willemmath/Bachelorproef-2022/Administratie/Interessante info.txt

Interessante links/info

Impulse response REW
https://www.roomeqwizard.com/help/help_en-GB/html/impulseresponse.html

Quasi-anechoic measurement
https://www.audiosciencereview.com/forum/index.php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

beamforming
https://www.hindawi.com/journals/jece/2013/718574/#EEq5

USB audio PIC
https://www.microchip.com/en-us/solutions/consumer/audio-and-speech/pic32-digital-audio/pic32-usb-audio#

USB noise
https://andybrown.me.uk/2015/07/24/usb-filtering/

USB margins clock
https://docs.opentitan.org/hw/ip/usbdev/doc/#:~:text=The%20USB%20Full%2DSpeed%20interface,accurate%2048%20MHz%20clock%20source.
