willemmath/Bachelorproef-2022/Administratie/Weekverslagen/weekv_6_Willem_Mathieu_EI.docx

# Tussentijds opvolgingsformulier Bachelorproef 2021-2022

__

Bachelorproef: MEMS microfoon in pro audio

Bedrijf: Thomas More

Student: Willem Mathieu

Promotor: Nick Steen

Bedrijfspromotor: Pedro Wyns

Opleiding: Elektronica-ICT Embedded Hardware

Stageweek: Week 6

Gerealiseerd vorige week:

PCB schematic gemaakt.

Begonnen aan de PCB layout.

Doelstellingen voor de volgende week:

PCB Layout afwerken.

PCB bestellen.

Opmerkingen bedrijfspromotor:

Opmerkingen hogeschoolpromotor:
