willemmath/Bachelorproef-2022/Administratie/Weekverslagen/weekv_7_Willem_Mathieu_EI.docx

# Tussentijds opvolgingsformulier Bachelorproef 2021-2022

__

Bachelorproef: MEMS microfoon in pro audio

Bedrijf: Thomas More

Student: Willem Mathieu

Promotor: Nick Steen

Bedrijfspromotor: Pedro Wyns

Opleiding: Elektronica-ICT Embedded Hardware

Stageweek: Week 7

Gerealiseerd vorige week:

PCB layout verder uitgewerkt.

Extra componenten besteld.

Doelstellingen voor de volgende week:

PCB Layout afwerken.

PCB bestellen.

Opmerkingen bedrijfspromotor:

Opmerkingen hogeschoolpromotor:
