willemmath/Bachelorproef-2022/Administratie/Weekverslagen/weekv_X_Willem_Mathieu_EI.docx

# Tussentijds opvolgingsformulier Bachelorproef 2021-2022

__

Bachelorproef: MEMS microfoon in pro audio

Bedrijf: Thomas More

Student: Willem Mathieu

Promotor: Nick Steen

Bedrijfspromotor: Pedro Wyns

Opleiding: Elektronica-ICT Embedded Hardware

Stageweek: Week x

Gerealiseerd vorige week:

Doelstellingen voor de volgende week:

Opmerkingen bedrijfspromotor:

Opmerkingen hogeschoolpromotor:
