willemmath/Bachelorproef-2022/Administratie/Weekverslagen/Week4_teamgantt.pdf

1114 | 21 | 28
7 | 14 | 21 | 28
4 | 11 | 18 | 25

2

9 | 16 | 23
2/22 | 3/22 | 4/22 | 5/22
MEMS Pro Audio | 0h | 42%
Administratie | 0h | 64%
Opstartverlsag afmaken
0 100%
Github opstellen
0 100%
Template weekverslag maken 0 100%
Week 1
0 100%
Week 2
0 100%
Week 3
0 100%
Week 4
0 | 0%
Week 5
0 | 0%
Week 6
0 | 0%
Week 7
0 | 0%
Week 8
0 | 0%
Week 9
0 | 0%
Week 10
0 | 0%
Week 11
0 | 0%
Week 12
0 | 0%
Les scriptie
0 100%
Les presentatie
0 | 100%
Marktonderzoek | 0h | 100%
Zoeken en bestellen
0 100%
Info verzamelen test-items
0 100%
Ontvangen van bestelling
0 100%
Solderen van connectoren
0 100%
testen van componenten
0 100%
Mock test-setup opstellen
0 100%
REW of alternatief opstellen 0 100%
Acoustische kamer opstellen 0 100%
Meting van componenten
0 100%
Analyse en selectie van MEMS 0 100%
Marktonderzoek gedaan
0 | 100%
Prototype ontwikkelen | 0h | 20%
Onderzoek USB audio class
0 | 80%
Onderzoek noise cancelling
0 100%
Concept uitwerken
0 | 90%
Componenten kiezen
0 | 30%
PCB ontwerpen
0 | 0%
PCB bestellen
0 | 0%
Componenten bestellen
0 | 0%
PCB ontvangen
0 | 0%
Componenten ontvangen
0 | 0%
PCB bestukken
0 | 0%
PCB software integreren
0 | 0%
Behuizing ontwerpen
0 | 0%
Behuizing maken
0 | 0%
Breadboard versie samenstellen
0 | 0%
Breadboard programmeren
0 | 0%
DSP verdiepend onderzoek
0 | 0%
DSP Programmeren
0 | 0%

Powered by TCPDF (www.tcpdf.org)
