willemmath/Bachelorproef-2022/Administratie/Weekverslagen/Week2_teamgantt.pdf

1114 | 21 | 28
7 | 14 | 21 | 28
4 | 11 | 18 | 25

2

9 | 16 | 23
2/22 | 3/22 | 4/22 | 5/22
MEMS Pro Audio | 23%
Administratie | 56%
Opstartverlsag afmaken | 100%
Github opstellen | 100%
Template weekverslag maken | 100%
Week 1 | 100%
Week 2 | 90%
Week 3 | 0%
Week 4 | 0%
Week 5 | 0%
Week 6 | 0%
Week 7 | 0%
Week 8 | 0%
Week 9 | 0%
Week 10 | 0%
Week 11 | 0%
Week 12 | 0%
Les scriptie | 100%
Les presentatie | 0%
Marktonderzoek | 76%
Zoeken en bestellen | 100%
Info verzamelen test-items | 100%
Ontvangen van bestelling | 100%
Solderen van connectoren | 100%
testen van componenten | 100%
Mock test-setup opstellen | 100%
REW of alternatief opstellen | 100%
Acoustische kamer opstellen | 100%
Meting van componenten | 30%
Analyse en selectie van MEMS | 0%
Marktonderzoek gedaan | 0%
Prototype ontwikkelen | 0%
Onderzoek USB audio class | 0%
Onderzoek noise cancelling | 0%
Concept uitwerken | 0%
Componenten kiezen | 0%
PCB ontwerpen | 0%
PCB bestellen | 0%
Componenten bestellen | 0%
PCB ontvangen | 0%
Componenten ontvangen | 0%
PCB bestukken | 0%
PCB software integreren | 0%
Behuizing ontwerpen | 0%
Behuizing maken | 0%
Breadboard versie samenstellen | 0%
Breadboard programmeren | 0%
DSP verdiepend onderzoek | 0%
DSP Programmeren | 0%

Powered by TCPDF (www.tcpdf.org)
