willemmath/Bachelorproef-2022/Administratie/Content/Presentatie/tussentijdse/tussentijdse presentatie.pptx

## Haalbaarheidsonderzoek betreffende het gebruik van de nieuwste generatie MEMS microfoons voor professionele audio

1/12

Willem Mathieu

## Waar?

- Thomas More
- Pedro Wyns

2/12

## Wat?

3/12

Haalbaarheidsonderzoek
MEMS technologie in pro audio
Product ontwikkelen
Berekeningen
Ontwerpen
Produceren
Metingen

## Haalbaarheidsonderzoek

- Wat is een MEMS?
  - Micro ElectroMechanical System
  - Mechanisch systeem op een IC
  - Veel terug te vinden op smart-devices

4/12

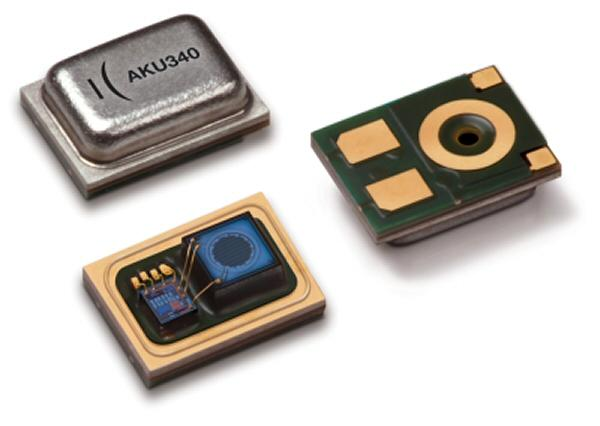
[picture p56: figure]
Innovations and Trends on the rising curve to prove favorable for growth of MEMS Microphone Market

## Haalbaarheidsonderzoek

- Testen van verschillende MEMS microfoons
- Vergelijken met andere microfoons
- Analyse en conclusies trekken

5/12

## Product ontwikkelen

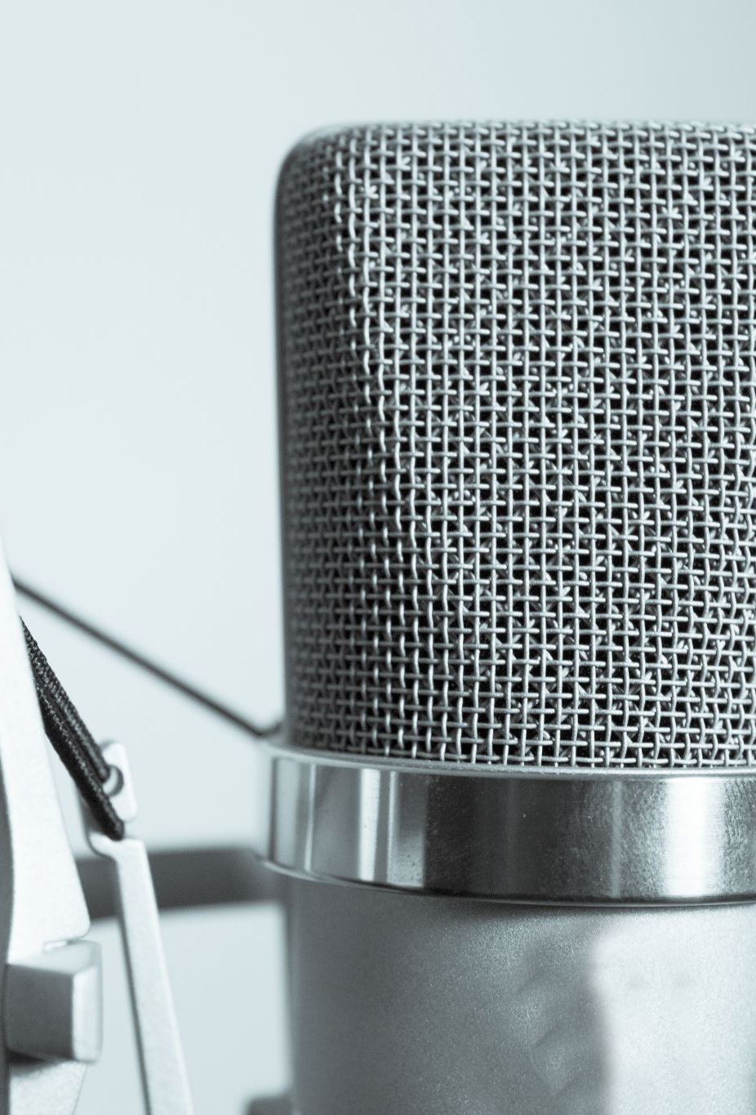
[picture p57: figure]
Microfoon tegen een witte achtergrond

6/12

- Zelf een microfoon ontwikkelen
  - Met MEMS
  - USB verbinding
  - Een vorm van noise cancelling
  - DSP technieken

## Wat heb ik al bereikt?

7/12

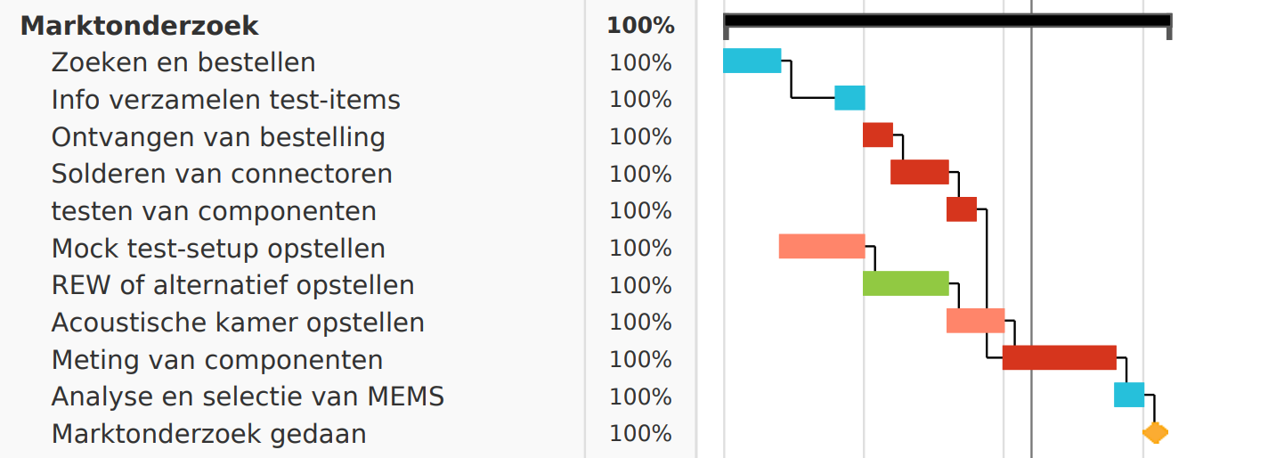
[picture p58: figure]

## Resultaten onderzoek

8/12

Naam | Noise floor (Db SPL) | Clipping point (db SPL) | Signal to noise ratio (dB)
Dayton Audio IMM-6 | 58.5 | 101 | 42.5
Shure sm57 | 33.3 | 122 | 88.7
Infineon | 40.7 | 130 | 89.3
ST | 32.3 | 120 | 87.7
CUI top | 37.2 | 119 | 81.8
CUI bottom | 34.7 | 115 | 80.3

## Resultaten onderzoek

Naam | Noise floor (Db SPL) | Clipping point (db SPL) | Signal to noise ratio (dB)
Dayton Audio IMM-6 | 58.5 | 101 | 42.5
Shure sm57 | 33.3 | 122 | 88.7
Infineon | 40.7 | 130 | 89.3
ST | 32.3 | 120 | 87.7
CUI top | 37.2 | 119 | 81.8
CUI bottom | 34.7 | 115 | 80.3

## Resultaten Onderzoek

9/12

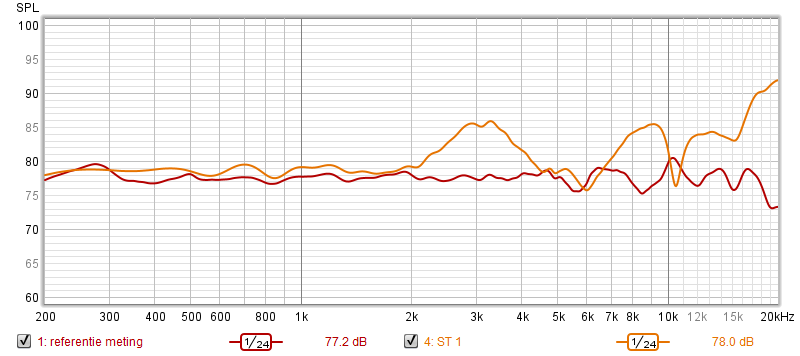
[picture p59: figure]
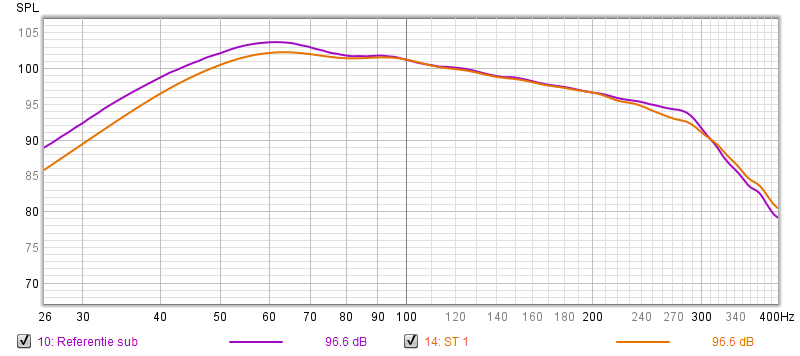
[picture p60: figure]

## Conclusie onderzoek

- Microfoons voldoen kwalitatief
- Directiviteit is een probleem

10/12

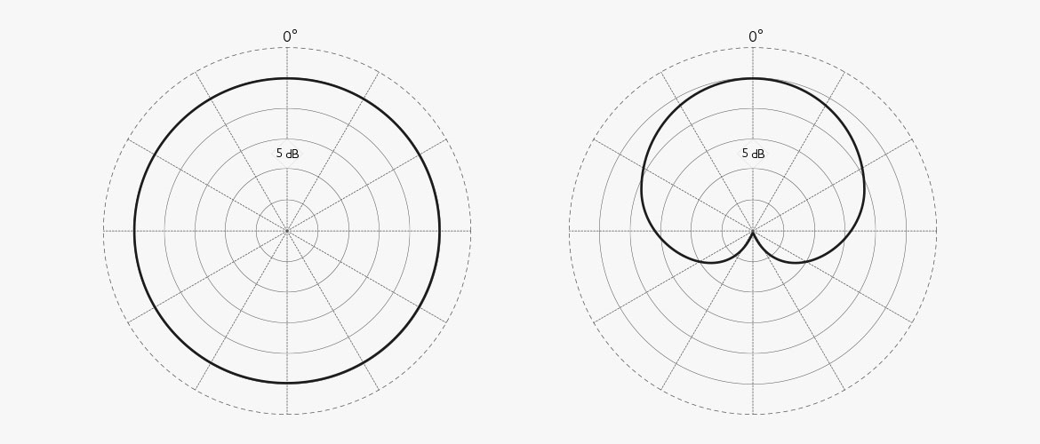
[picture p61: figure]
Omni or Cardioid - Choose the right headset microphone

## Wat nu nog?

11/12

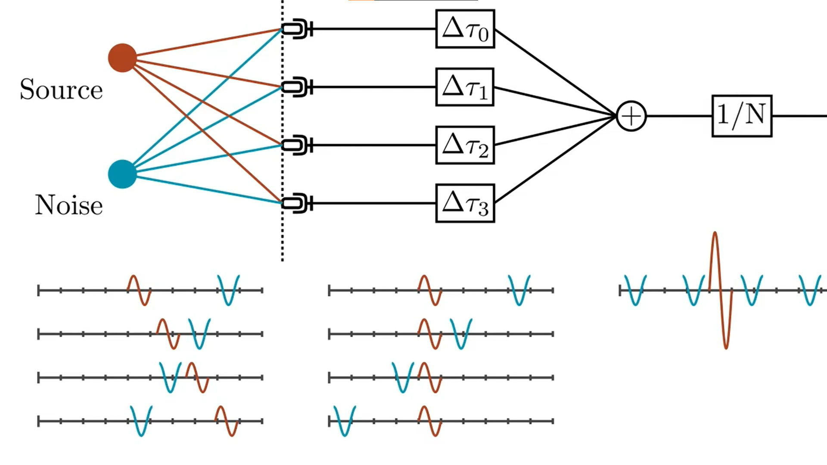
[picture p62: figure]

- Gebruik van phased array voor directiviteit
- Plaatsing microfoons bepalen a.d.h.v. een simulatie
- PCB ontwerpen
- Software schrijven
- Finaal testen

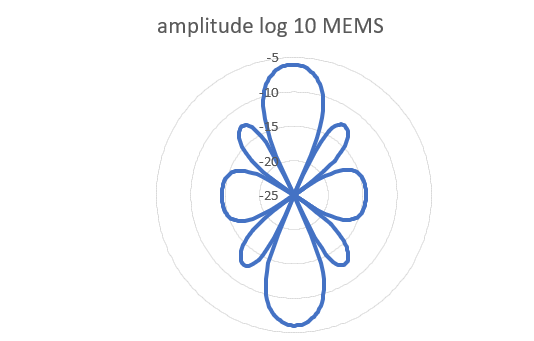
[picture p63: figure]

## Bedankt om te luisteren

Vragen?
