willemmath/Bachelorproef-2022/Administratie/Content/Berekeningen/Phased array amplitude sim voor scriptie.xlsx

Sheet: Sheet1
c | 343 | m/s
 |  |  |  |  | indv. Afstand |  |  | cumulatief |  |  | tijd afgelegd | seconden |  | faseverschil | rad |  | amplitude
d1 | 0.07 | m | hoek° | hoek rad | a1 | a2 | a3 | c1 | c2 | c3 | t1 | t2 | t3 | ϕ1 | ϕ2 | ϕ3 | A | Alog
d2 | 0.07 | m | 0 | 0 | 0 | 0 | 0 | 0 | 0 | 0 | 0.0002 | 0.0004 | 0.0006 | 1.256637061 | 2.513274123 | 3.769911184 | 0.25 | -12.04119983
d3 | 0.07 | m | 1 | 0.01745329252 | 0.001221668451 | 0.001221668451 | 0.001221668451 | 0.001221668451 | 0.002443336901 | 0.003665005352 | 0.0002035617156 | 0.0004071234312 | 0.0006106851468 | 1.279015981 | 2.558031961 | 3.837047942 | 0.230813576 | -12.38798642
 |  |  | 2 | 0.03490658504 | 0.002442964769 | 0.002442964769 | 0.002442964769 | 0.002442964769 | 0.004885929538 | 0.007328894308 | 0.0002071223463 | 0.0004142446925 | 0.0006213670388 | 1.301388083 | 2.602776166 | 3.904164249 | 0.2117746727 | -12.76185972
Freq | 1000 | Hz | 3 | 0.05235987756 | 0.003663516937 | 0.003663516937 | 0.003663516937 | 0.003663516937 | 0.007327033874 | 0.01099055081 | 0.0002106808074 | 0.0004213616148 | 0.0006320424222 | 1.323746554 | 2.647493107 | 3.971239661 | 0.1929069496 | -13.16712118
 |  |  | 4 | 0.06981317008 | 0.004882953162 | 0.004882953162 | 0.004882953162 | 0.004882953162 | 0.009765906324 | 0.01464885949 | 0.000214236015 | 0.0004284720301 | 0.0006427080451 | 1.346084582 | 2.692169164 | 4.038253746 | 0.1742335737 | -13.60928147
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
 |  |  | 360 | 6.283185307 | -1.715207837e-17 | -1.715207837e-17 | -1.715207837e-17 | -1.715207837e-17 | -3.430415674e-17 | -5.145623511e-17 | 0.0002 | 0.0004 | 0.0006 | 1.256637061 | 2.513274123 | 3.769911184 | 0.25 | -12.04119983

Sheet: Sheet2
Frequentie | 1000 | Hz
d1 | 0.07 | m
d2 | 0.07 | m
d3 | 0.07 | m
 |  |  |  | delay | 0
 |  |  | 208
 |  |  | 120.2264435
 |  |  | 70
