willemmath/Bachelorproef-2022/Project/Metingen/Mic holder.3mf

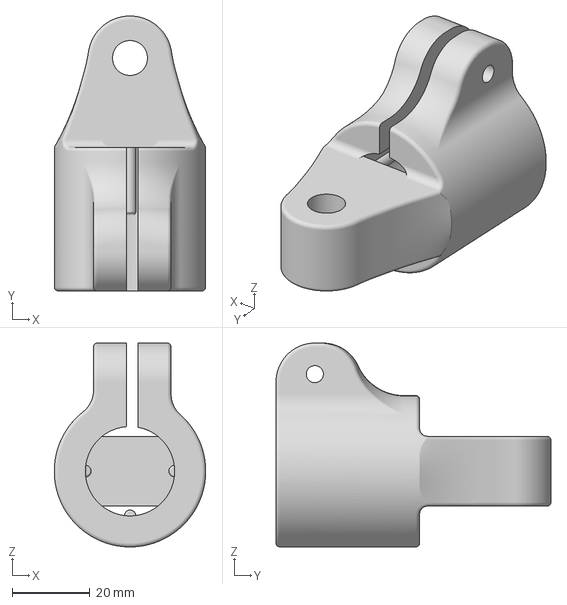
[picture p64: CAD file, 2022-02-23]
Project/Metingen/Mic holder.3mf
39.0 x 70.8 x 52.5 mm
