willemmath/Bachelorproef-2022/Project/Metingen/MEMS adapter.3mf

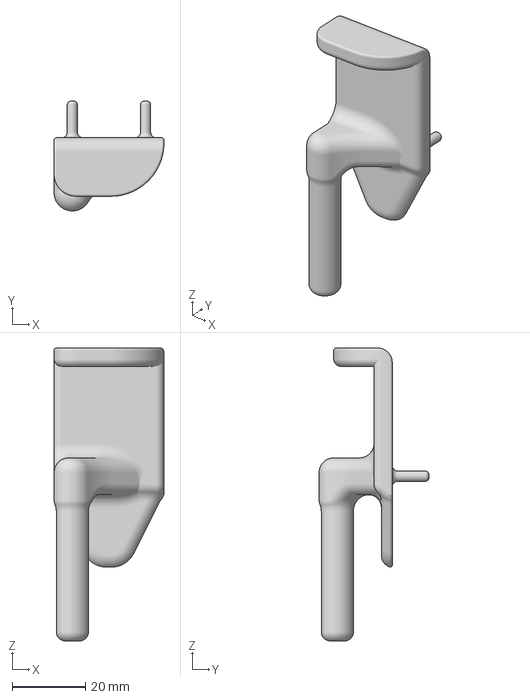
[picture p65: CAD file, 2022-02-23]
Project/Metingen/MEMS adapter.3mf
30.0 x 30.0 x 80.0 mm
