willemmath/Bachelorproef-2022/Administratie/Weekverslagen/weekv_6_Willem_Mathieu_EI.pdf

## Tussentijds opvolgingsformulier Bachelorproef 2021-2022

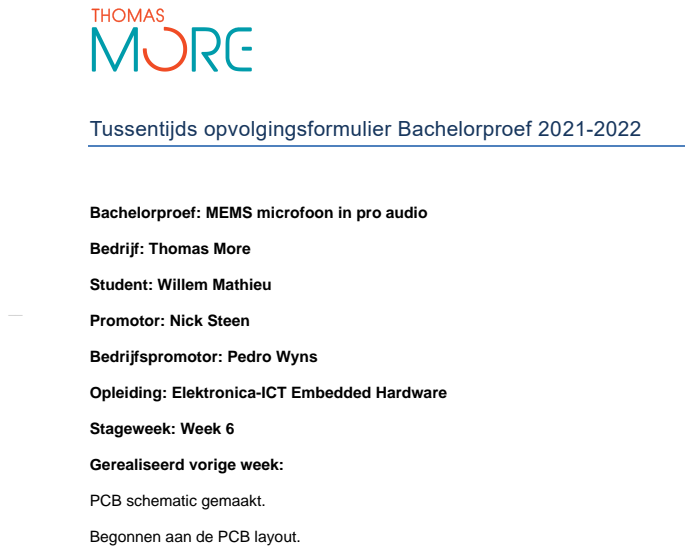
[picture p66: page 1]
Stageweek: Week 6

Bachelorproef: MEMS microfoon in pro audio

Bedrijf: Thomas More

Student: Willem Mathieu

Promotor: Nick Steen

Bedrijfspromotor: Pedro Wyns

Opleiding: Elektronica-ICT Embedded Hardware

Gerealiseerd vorige week:

PCB schematic gemaakt.

Begonnen aan de PCB layout.

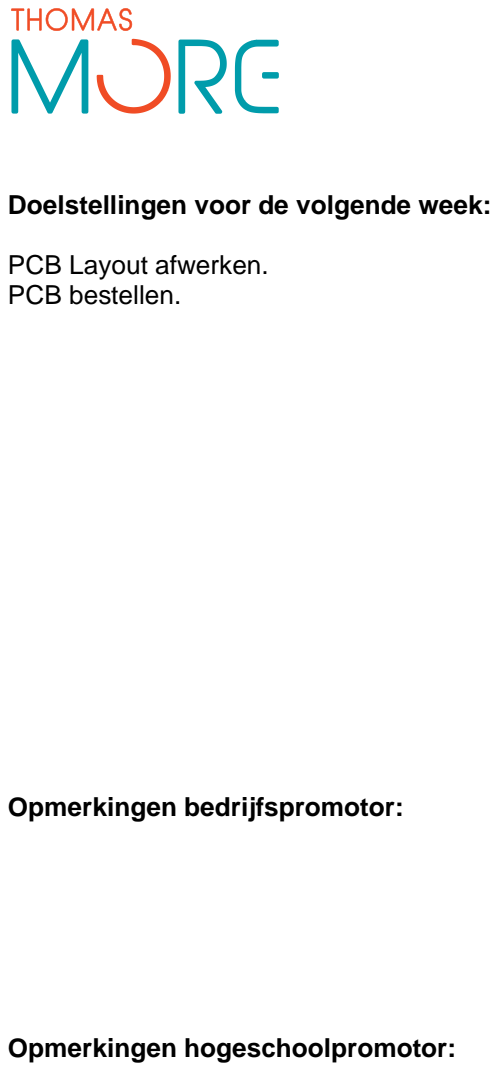
[picture p67: page 2]
Opmerkingen bedrijfspromotor:; Opmerkingen hogeschoolpromotor:

Doelstellingen voor de volgende week:

PCB Layout afwerken.
PCB bestellen.
