willemmath/Bachelorproef-2022/Project/Prototype 1/PCB/schematic_pcb.pdf

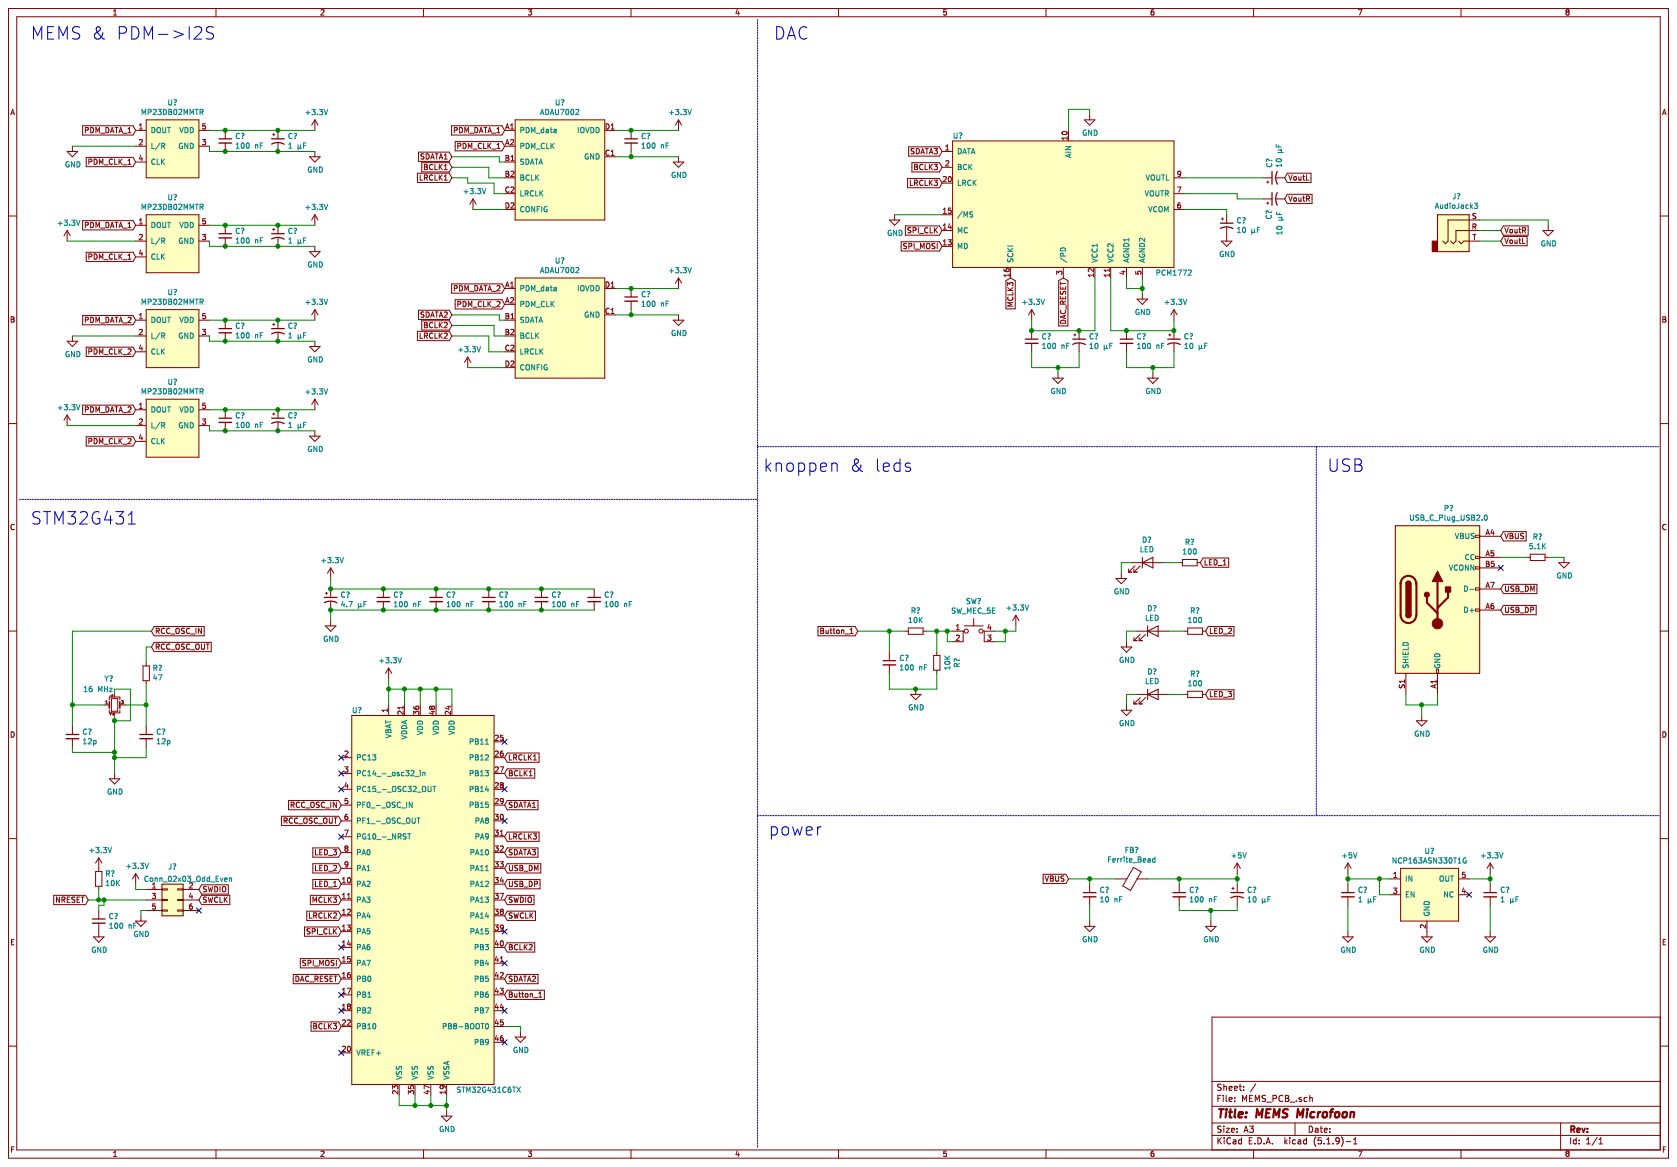
[picture p70: page 1]
