willemmath/Bachelorproef-2022/Project/Prototype 1/PCB/schematic_pcb_v2.pdf

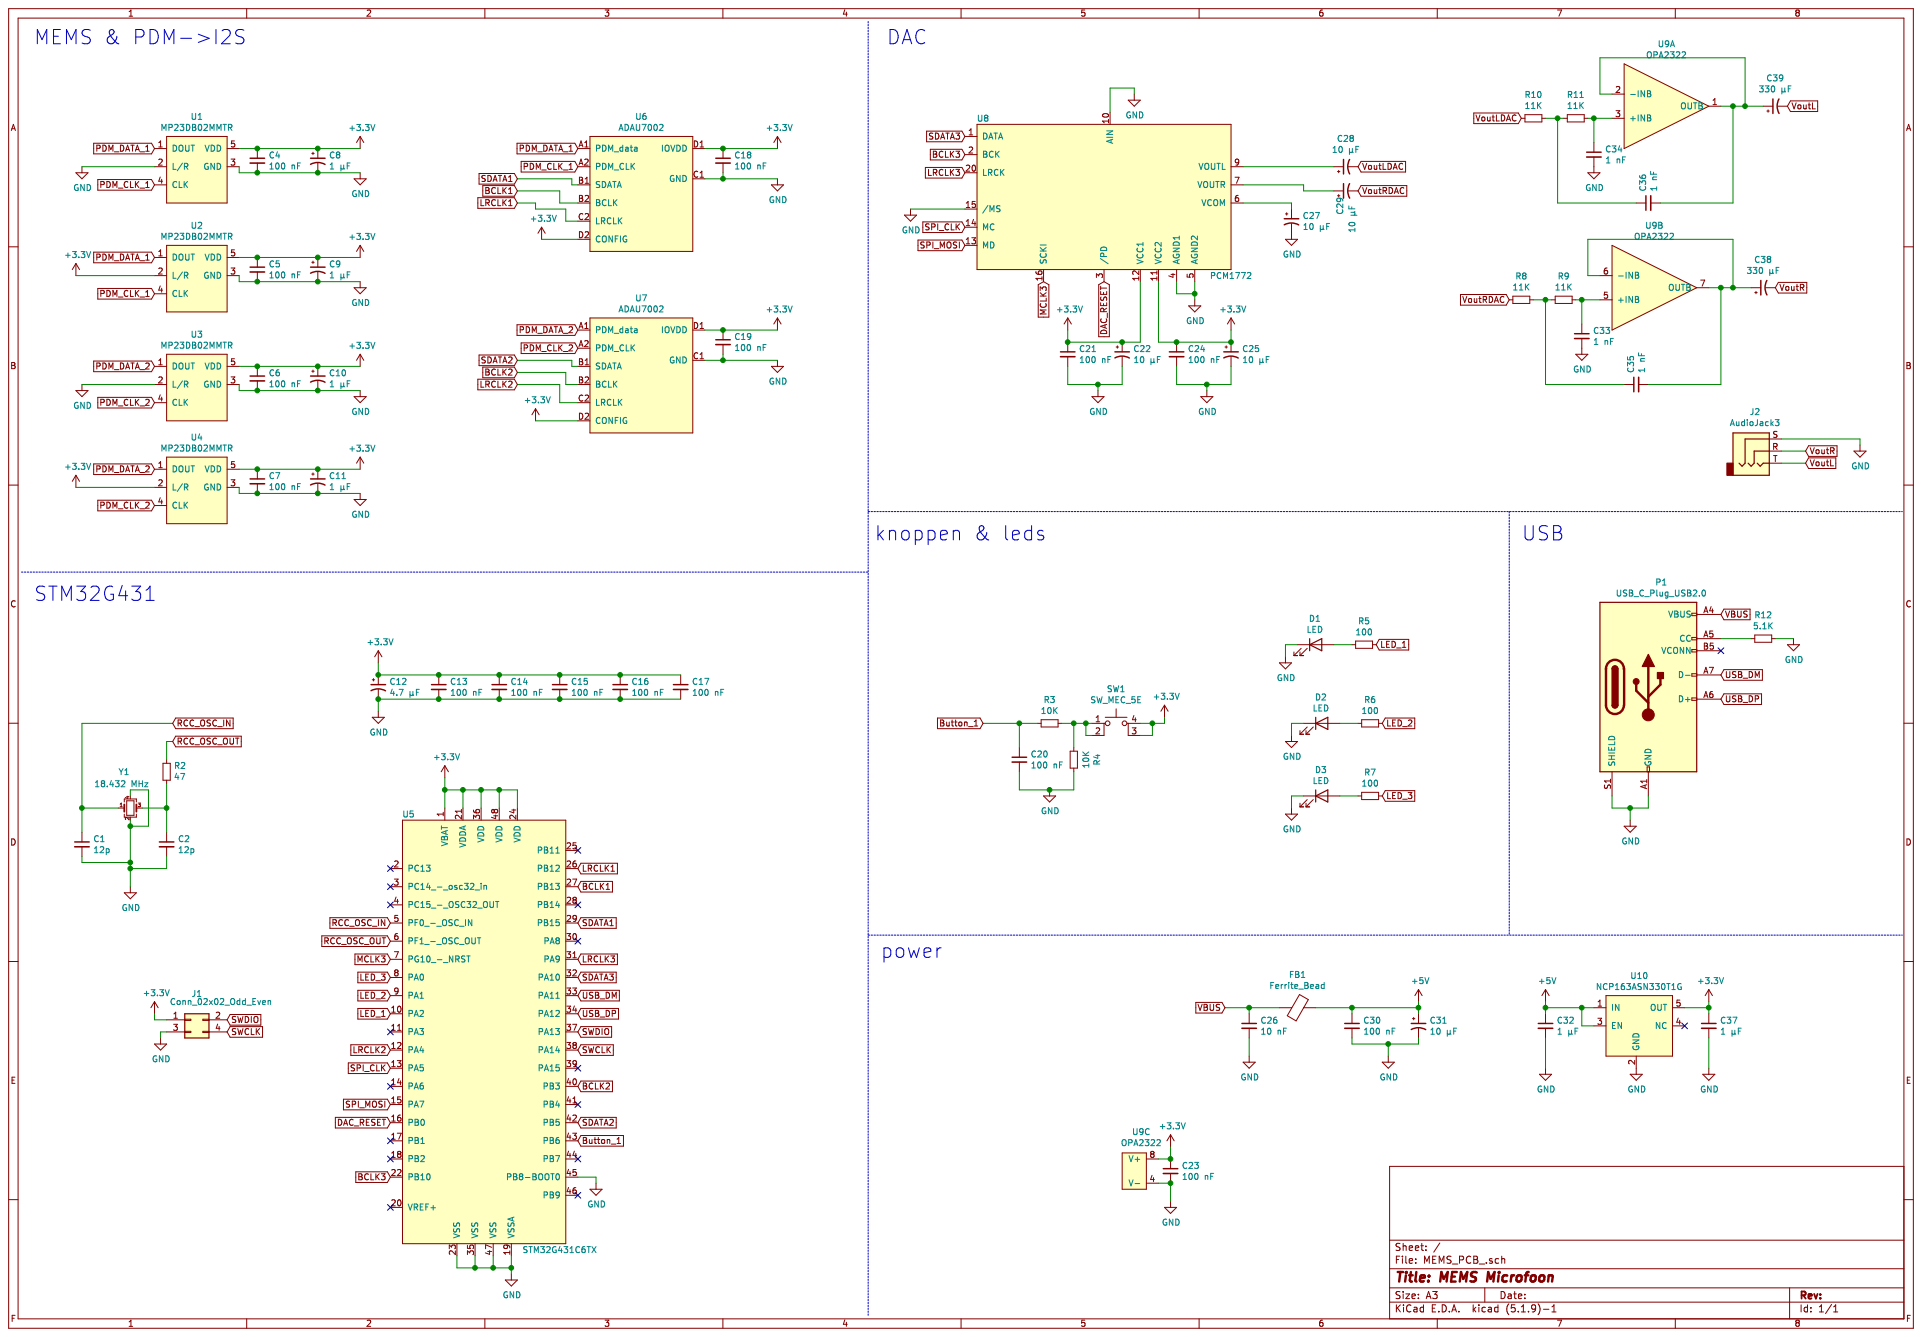
[picture p71: page 1]
