willemmath/Bachelorproef-2022/Project/Prototype 1/PCB/PCB_PDF.pdf

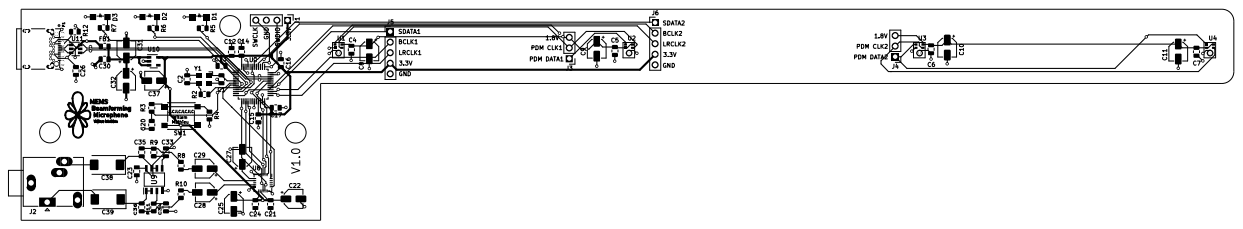
[picture p72: page 1]
