willemmath/Bachelorproef-2022/Project/Prototype 1/Software/Core/Src/main.c

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
/* Includes ------------------------------------------------------------------*/
#include "main.h"
#include "usb_device.h"

I2S_HandleTypeDef hi2s2;
I2S_HandleTypeDef hi2s3;
DMA_HandleTypeDef hdma_spi2_rx;
DMA_HandleTypeDef hdma_spi3_rx;

SAI_HandleTypeDef hsai_BlockA1;
DMA_HandleTypeDef hdma_sai1_a;

SPI_HandleTypeDef hspi1;

/* USER CODE BEGIN PV */

uint16_t rxBuf[8];
uint16_t rxBuf2[8];
uint8_t txBuf[16];

uint8_t mode = 1;
uint16_t counter = 0;

int U1Sample = 0;
int U2Sample = 0;
int U3Sample = 0;
int U4Sample = 0;

/* USER CODE END PV */

void SystemClock_Config(void);
static void MX_GPIO_Init(void);
static void MX_DMA_Init(void);
static void MX_I2S2_Init(void);
static void MX_I2S3_Init(void);
static void MX_SAI1_Init(void);
static void MX_SPI1_Init(void);
/**
  * @brief  The application entry point.
  * @retval int
  */
int main(void)
{
  /* MCU Configuration--------------------------------------------------------*/

  /* Reset of all peripherals, Initializes the Flash interface and the Systick. */
  HAL_Init();

  /* Configure the system clock */
  SystemClock_Config();

  /* Initialize all configured peripherals */
  MX_GPIO_Init();
  MX_DMA_Init();
  MX_I2S2_Init();
  MX_I2S3_Init();
  MX_SAI1_Init();
  MX_SPI1_Init();
  MX_USB_Device_Init();
  /* USER CODE BEGIN 2 */

  HAL_I2S_Receive_DMA(&hi2s2, rxBuf, 4);
  HAL_I2S_Receive_DMA(&hi2s3, rxBuf2, 4);
  HAL_SAI_Transmit_DMA(&hsai_BlockA1, txBuf, 4);




  HAL_Delay(100);


  HAL_GPIO_WritePin(LED1_GPIO_Port,LED1_Pin,(mode == 1));
  HAL_GPIO_WritePin(DAC_RESET_GPIO_Port,DAC_RESET_Pin,1);


  /* USER CODE END 2 */

  /* Infinite loop */
  /* USER CODE BEGIN WHILE */
  while (1)
  {

	  //HAL_GPIO_WritePin(LED3_GPIO_Port,LED3_Pin,1);

/*

     for(int i = 0; i<16; i++){
  		  if(i == mode-1){
  			  txBuf[i] = 0xff;
  		  }
  		  else{
  			  txBuf[i] = 0b00000000;
  		  }
  	  }

/*



	  for(int i = 0; i<16; i++){
		  if(i == mode-1){
			  txBuf[i] = rxBuf[0] & 0xff;
		  }
		  if(i == mode){
			  txBuf[i] = rxBuf[0] >>8;
		  }
		  else{
			  txBuf[i] = 0b00000000;
		  }

	  }

		*/


	  if(HAL_GPIO_ReadPin(Button1_GPIO_Port,Button1_Pin)==1){
		  if(mode == 3){
			  mode = 1;
		  }
		  else{
			  mode++;
		  }

		  HAL_GPIO_WritePin(LED1_GPIO_Port,LED1_Pin,(mode == 1));
		  HAL_GPIO_WritePin(LED2_GPIO_Port,LED2_Pin,(mode == 2));
		  HAL_GPIO_WritePin(LED3_GPIO_Port,LED3_Pin,(mode == 3));

		  while(HAL_GPIO_ReadPin(Button1_GPIO_Port,Button1_Pin)==1);
	  }









    /* USER CODE END WHILE */

    /* USER CODE BEGIN 3 */
  }







  /* USER CODE END 3 */
}

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
/* USER CODE BEGIN 4 */

void HAL_I2S_RxCpltCallback(I2S_HandleTypeDef *hi2s){


/*

	int lSample = (int) (rxBuf2[0]<<16 | rxBuf2[1]);




*/
	if(mode == 1){

		txBuf[3]= (rxBuf2[0]>>8) & 0xFF;
		txBuf[2]=  rxBuf2[0] & 0xFF;
		txBuf[1]= (rxBuf2[1]>>8) & 0xFF;
		txBuf[0]=  rxBuf2[1] & 0xFF;

	}


	if(mode == 2){

		U3Sample = (int) (rxBuf2[0]<<16 | rxBuf2[1]);
		U4Sample = (int) (rxBuf2[2]<<16 | rxBuf2[3]);

		int TXSample =  (U3Sample>>1) + (U4Sample>>1);

		txBuf[3] = (TXSample >> 24)  & 0xFF ;
		txBuf[2] = (TXSample >> 16)  & 0xFF ;
		txBuf[1] = (TXSample >> 8 )  & 0xFF ;
		txBuf[0] = (TXSample )       & 0xFF ;

	}

	if(mode == 3){

		U1Sample = (int) ( rxBuf[0]<<16 | rxBuf[1]);
		U2Sample = (int) ( rxBuf[2]<<16 | rxBuf[3]);
		U3Sample = (int) (rxBuf2[0]<<16 | rxBuf2[1]);
		U4Sample = (int) (rxBuf2[2]<<16 | rxBuf2[3]);

		int TXSample = (U1Sample>>2) + (U2Sample>>2) + (U3Sample>>2) + (U4Sample>>2);

		txBuf[3] = (TXSample >> 24)  & 0xFF ;
		txBuf[2] = (TXSample >> 16)  & 0xFF ;
		txBuf[1] = (TXSample >> 8 )  & 0xFF ;
		txBuf[0] = (TXSample )       & 0xFF ;

	}



	/* deze wel nodig!!
	txBuf[7]= (rxBuf2[2]>>8) & 0xFF;
	txBuf[6]=  rxBuf2[2] & 0xFF;
	txBuf[5]= (rxBuf2[3]>>8) & 0xFF;
	txBuf[4]=  rxBuf2[3] & 0xFF;

	*/

	/*dit is voor de U1 MEMS

	if(mode == 3){

		txBuf[3]= (rxBuf[0]>>8) & 0xFF;
		txBuf[2]=  rxBuf[0] & 0xFF;
		txBuf[1]= (rxBuf[1]>>8) & 0xFF;
		txBuf[0]=  rxBuf[1] & 0xFF;

	}

 */

	  UNUSED(hi2s);
}





void HAL_I2S_RxHalfCpltCallback(I2S_HandleTypeDef *hi2s){



	if(mode == 1){
		txBuf[11]= (rxBuf2[4]>>8) & 0xFF;
		txBuf[10]=  rxBuf2[4] & 0xFF;
		txBuf[9]= (rxBuf2[5]>>8) & 0xFF;
		txBuf[8]=  rxBuf2[5] & 0xFF;
	}

	if (mode == 2){

		U3Sample = (int) (rxBuf2[4]<<16 | rxBuf2[5]);
		U4Sample = (int) (rxBuf2[6]<<16 | rxBuf2[7]);

		int TXSample =  (U3Sample>>1) + (U4Sample>>1);

		txBuf[11] = (TXSample >> 24)  & 0xFF ;
		txBuf[10] = (TXSample >> 16)  & 0xFF ;
		txBuf[9]  = (TXSample >> 8 )  & 0xFF ;
		txBuf[8]  = (TXSample )       & 0xFF ;

	}

	if(mode == 3){

		U1Sample = (int) ( rxBuf[4]<<16 | rxBuf[5]);
		U2Sample = (int) ( rxBuf[6]<<16 | rxBuf[7]);
		U3Sample = (int) (rxBuf2[4]<<16 | rxBuf2[5]);
		U4Sample = (int) (rxBuf2[6]<<16 | rxBuf2[7]);

		int TXSample = (U1Sample>>2) + (U2Sample>>2) + (U3Sample>>2) + (U4Sample>>2);

		txBuf[11] = (TXSample >> 24)  & 0xFF ;
		txBuf[10] = (TXSample >> 16)  & 0xFF ;
		txBuf[9]  = (TXSample >> 8 )  & 0xFF ;
		txBuf[8]  = (TXSample )       & 0xFF ;

	}

	/* deze wel nodig!!
	txBuf[15]= (rxBuf2[6]>>8) & 0xFF;
	txBuf[14]=  rxBuf2[6] & 0xFF;
	txBuf[13]= (rxBuf2[7]>>8) & 0xFF;
	txBuf[12]=  rxBuf2[7] & 0xFF;
    */

	/* dit is voor de U1 MEMS
	if(mode == 3){
		txBuf[11]= (rxBuf[4]>>8) & 0xFF;
		txBuf[10]=  rxBuf[4] & 0xFF;
		txBuf[9]= (rxBuf[5]>>8) & 0xFF;
		txBuf[8]=  rxBuf[5] & 0xFF;
	}
	*/

	UNUSED(hi2s);


}



/* USER CODE END 4 */
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
