willemmath/Bachelorproef-2022/Project/Prototype 1/Software/Software.ioc

Mcu.UserName=STM32G431C6Tx
PA0.GPIO_Label=LED1
PB0.GPIO_Label=DAC_RESET
PB6.GPIO_Label=Button1
PB13.Signal=I2S2_CK
PB15.Signal=I2S2_SD
PA12.Signal=USB_DP
PB6.Signal=GPIO_Input
PA0.Signal=GPIO_Output
PA2.GPIO_Label=LED3
PA10.Signal=SAI1_SD_A
PF1-OSC_OUT.Signal=RCC_OSC_OUT
PA13.Signal=SYS_JTMS-SWDIO
PG10-NRST.Signal=RCC_MCO
PA9.Signal=SAI1_FS_A
PA1.Signal=GPIO_Output
PB10.Signal=SAI1_SCK_A
PA5.Signal=SPI1_SCK
PA1.GPIO_Label=LED2
PA2.Signal=GPIO_Output
PB3.Signal=I2S3_CK
PA4.Signal=I2S3_WS
PB5.Signal=I2S3_SD
PA11.Signal=USB_DM
PA14.Signal=SYS_JTCK-SWCLK
PF0-OSC_IN.Signal=RCC_OSC_IN
PB0.Signal=GPIO_Output
PB12.Signal=I2S2_WS
PA7.Signal=SPI1_MOSI
