willemmath/Bachelorproef-2022/Project/Prototype 1/Software/Core/Inc/main.h

#define LED1_Pin GPIO_PIN_0
#define LED1_GPIO_Port GPIOA
#define LED2_Pin GPIO_PIN_1
#define LED2_GPIO_Port GPIOA
#define LED3_Pin GPIO_PIN_2
#define LED3_GPIO_Port GPIOA
#define DAC_RESET_Pin GPIO_PIN_0
#define DAC_RESET_GPIO_Port GPIOB
#define Button1_Pin GPIO_PIN_6
#define Button1_GPIO_Port GPIOB
