willemmath/Bachelorproef-2022/(commit log)

2022-02-18 Create vergelijking MEMS.xlsx
    [vergelijking MEMS.xlsx]
2022-02-23 Data van metingen en 3d modellen
    [MEMS adapter.3mf, Mic holder.3mf]
