willemmath/Bachelorproef-2022/(notices)

Notices in the files:
Project/Prototype 1/Software/Core/Src/main.c:
© Copyright (c) 2022 STMicroelectronics.
All rights reserved.
This software component is licensed by ST under Ultimate Liberty license
Project/Prototype 1/Software/Core/Inc/main.h:
(C) COPYRIGHT STMicroelectronics *****END OF FILE
